olincollege/hoverbois/website/assets/images/jgilbert.jpg

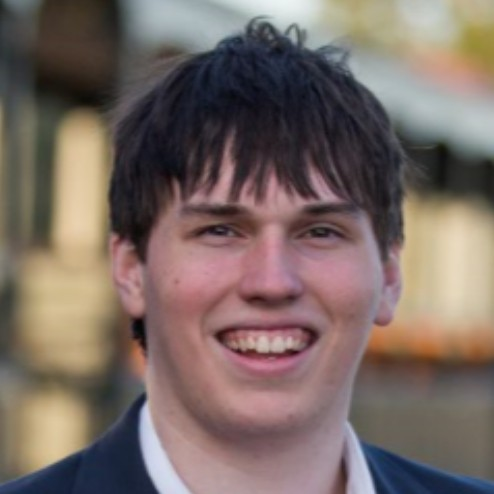
website/assets/images/jgilbert.jpg
