olincollege/hoverbois/README.md

# hoverbois
2022 pie project with William Skelly Devlin Ih Joseph Gilbert and Ethan Chen
