olincollege/hoverbois/website/content/docs/gallery/_index.md

---
title: Gallery
menu:
  navbar:
    weight: 20
---

# Media Gallery

# Videos:
{{<youtube 5YsUSeX58Ec>}}
{{< youtube F6ZGbz_ZIJE>}}
{{< youtube QIKaYoYOuRQ >}}

# Photos:

{{}}
{{}}
{{}}
{{}}
{{}}
{{}}
{{}}
{{}}
{{}}
