olincollege/hoverbois/website/assets/images/4View.jpg

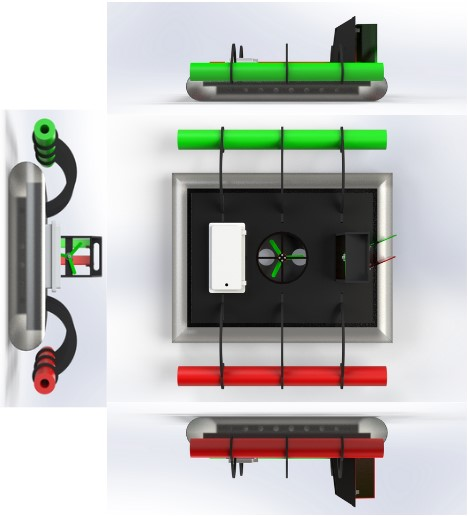
website/assets/images/4View.jpg
