olincollege/hoverbois/website/assets/images/Below_View.jpg

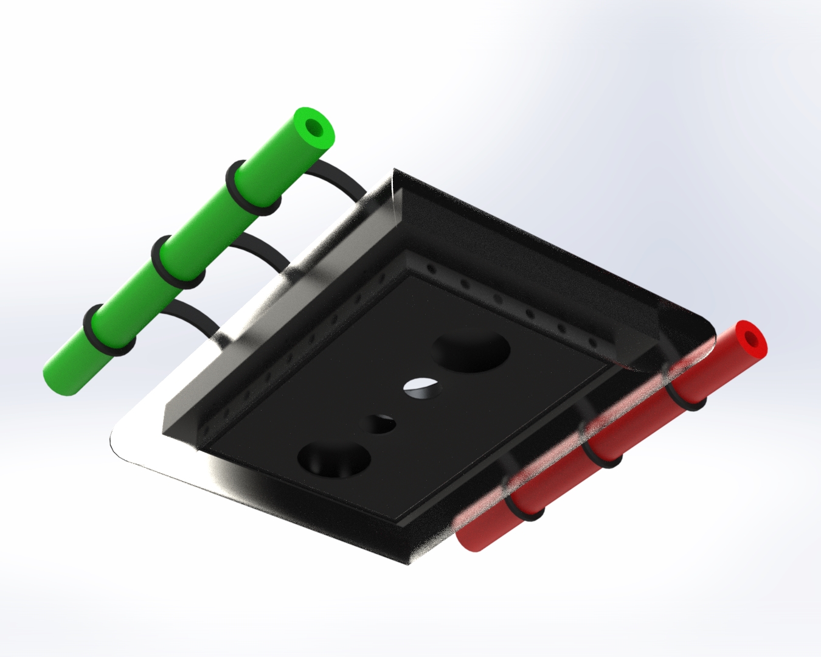
website/assets/images/Below_View.jpg
