olincollege/hoverbois/website/assets/images/devlin-ih.jpg

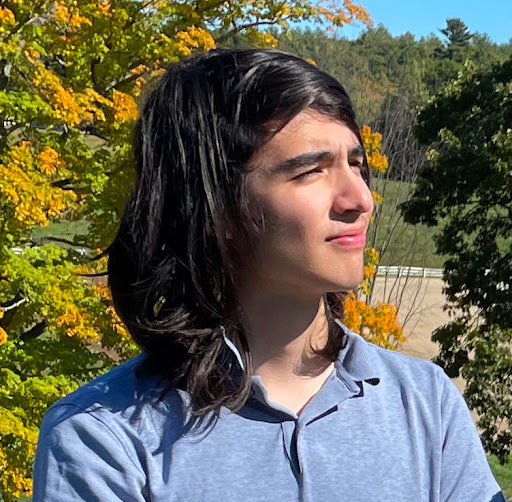
website/assets/images/devlin-ih.jpg
