olincollege/hoverbois/website/assets/images/Ethan_Chen.jpg

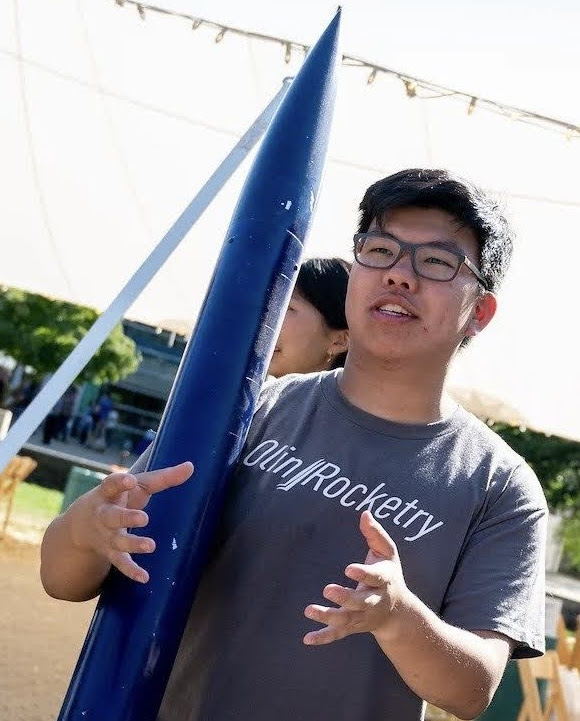
website/assets/images/Ethan_Chen.jpg
