olincollege/hoverbois/website/assets/images/Front_View.jpg

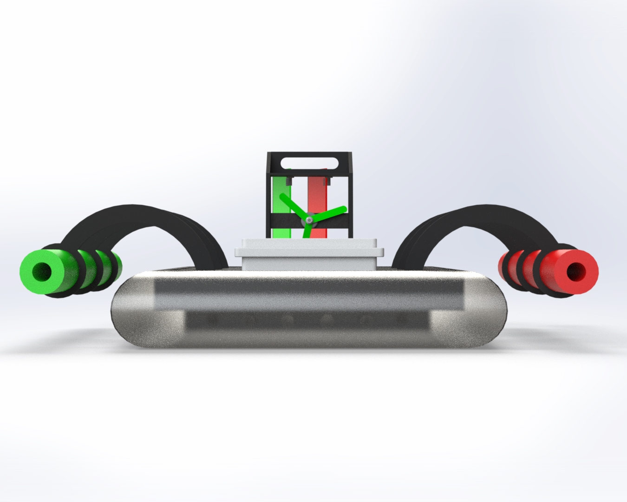
website/assets/images/Front_View.jpg
