olincollege/hoverbois/website/assets/images/IMG_1029.JPG

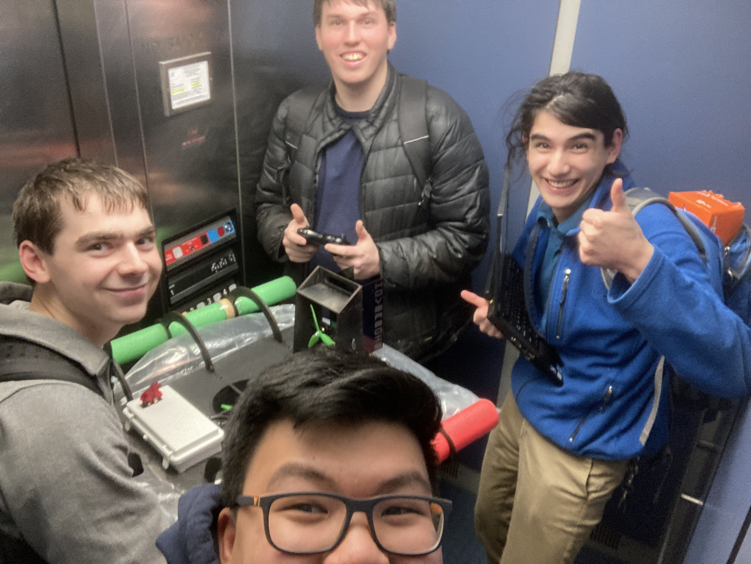
website/assets/images/IMG_1029.JPG
