olincollege/hoverbois/website/assets/images/IMG_1030.JPG

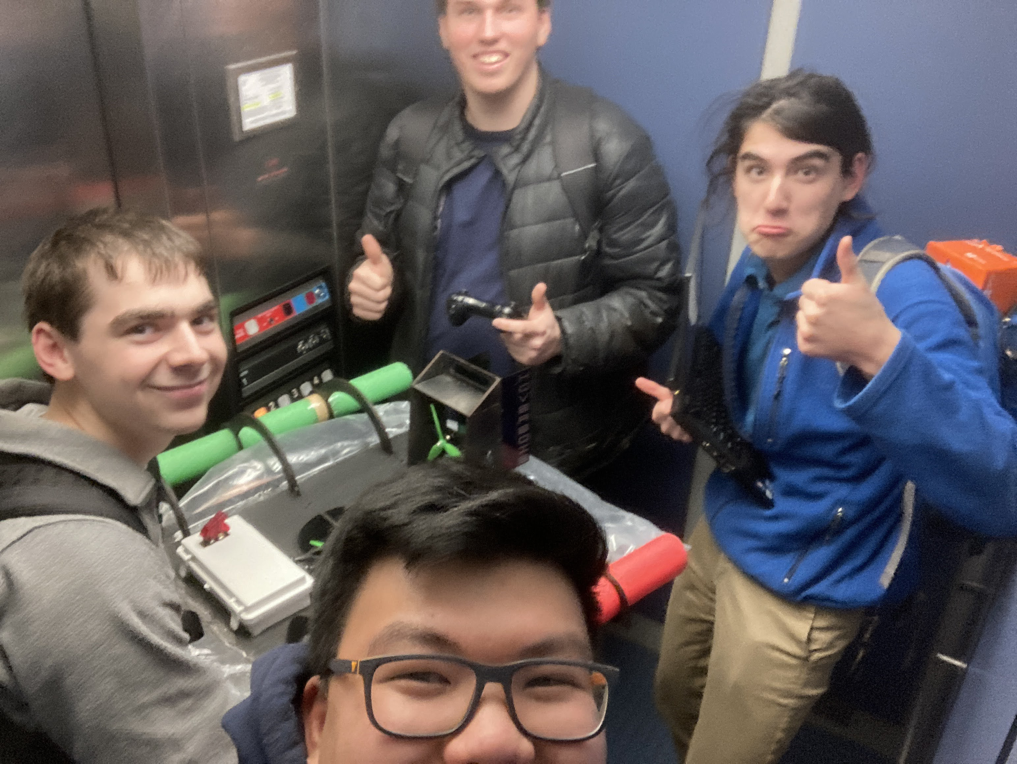
website/assets/images/IMG_1030.JPG
