olincollege/hoverbois/website/assets/images/IMG_1031.JPG

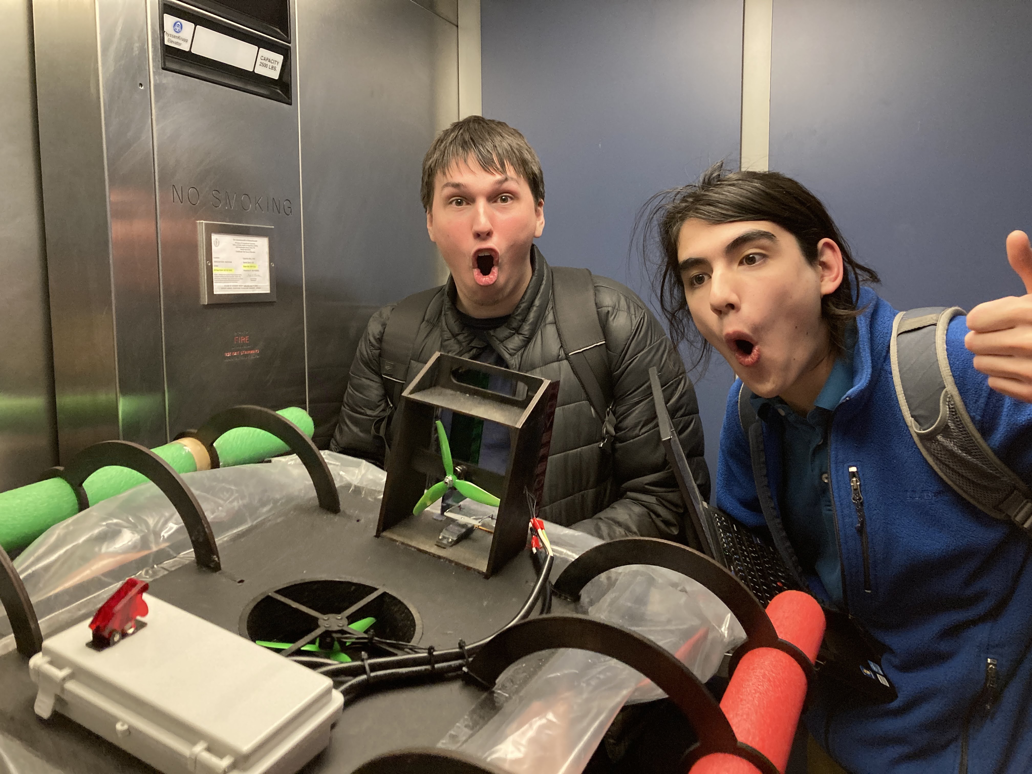
website/assets/images/IMG_1031.JPG
