olincollege/hoverbois/website/assets/images/IMG_1032.JPG

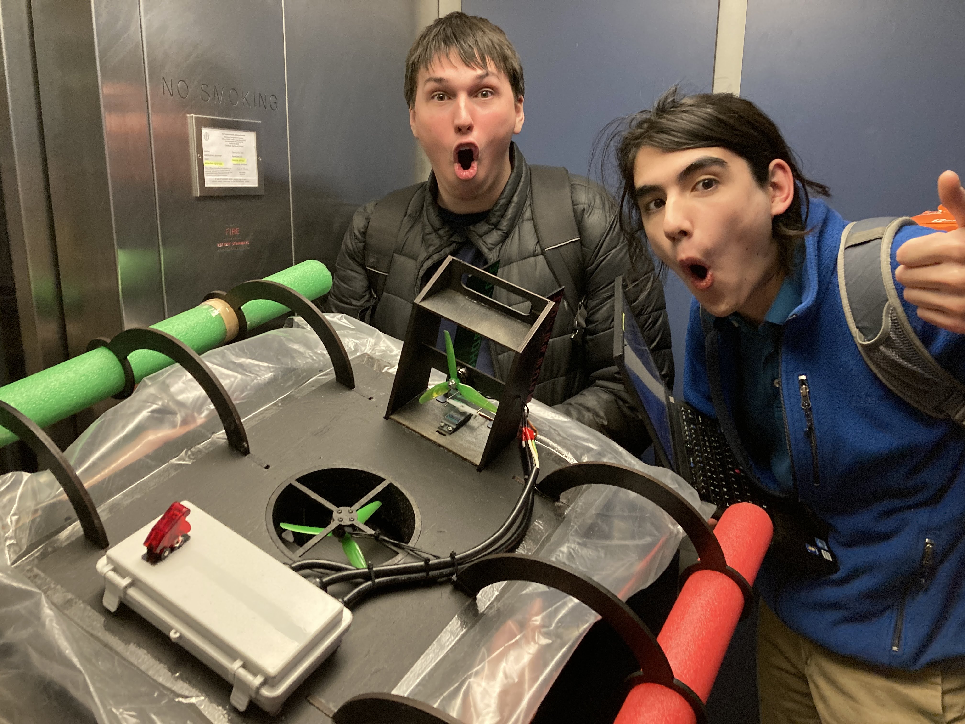
website/assets/images/IMG_1032.JPG
