olincollege/hoverbois/website/assets/images/Iso_Sharp.jpg

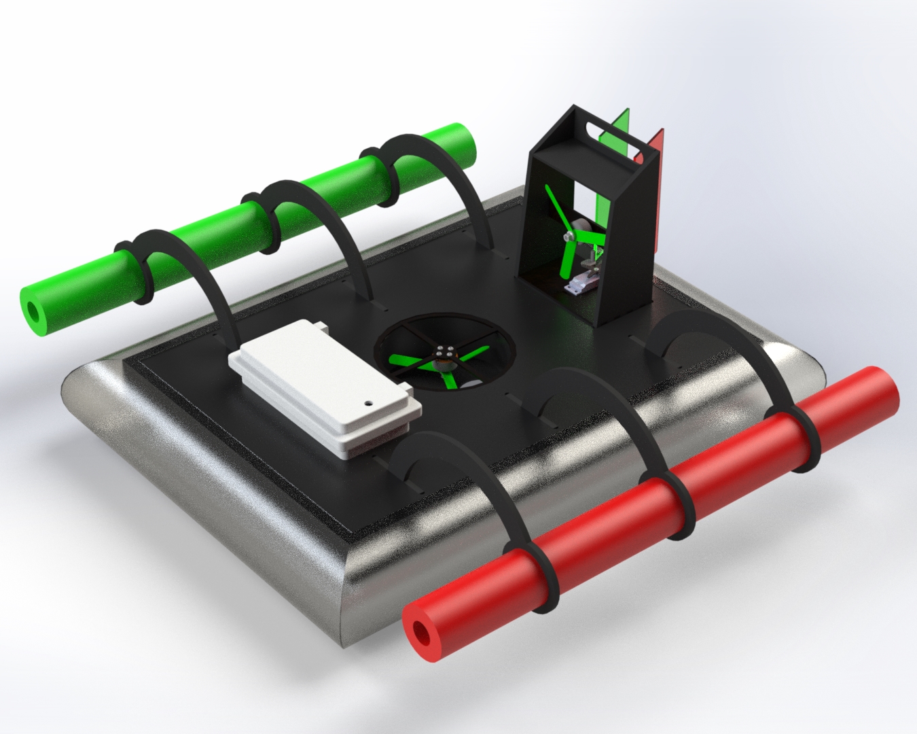
website/assets/images/Iso_Sharp.jpg
