olincollege/hoverbois/website/assets/images/Low_View.jpg

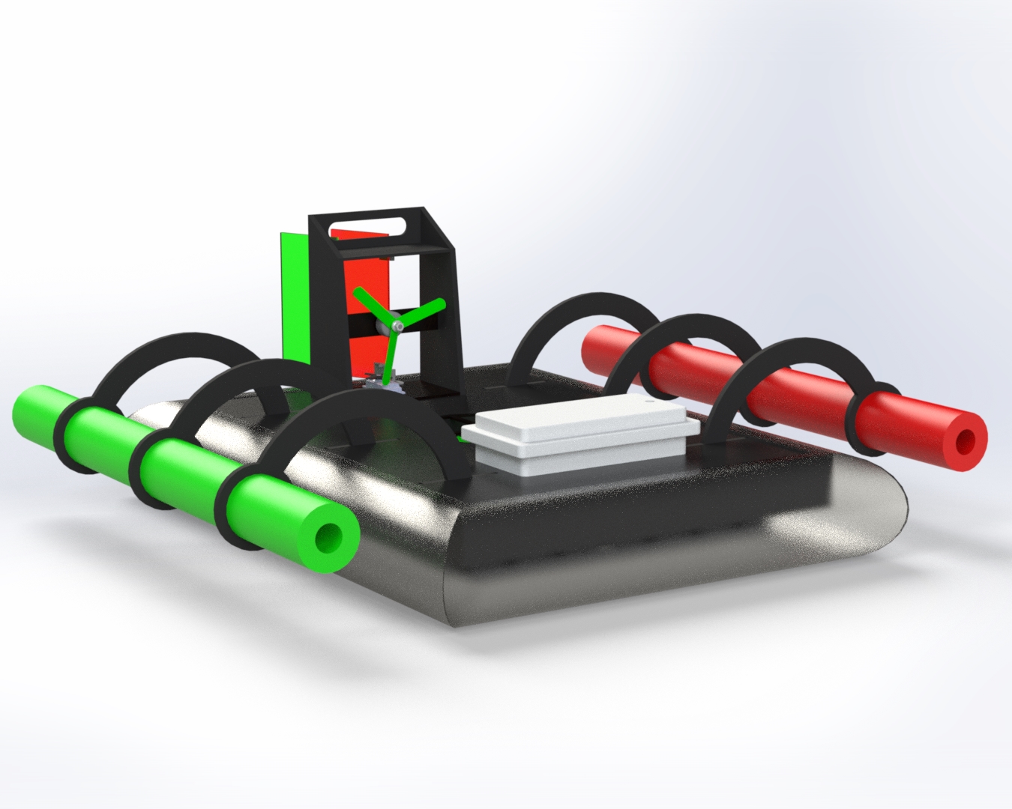
website/assets/images/Low_View.jpg
