olincollege/hoverbois/website/assets/images/Side_Port.jpg

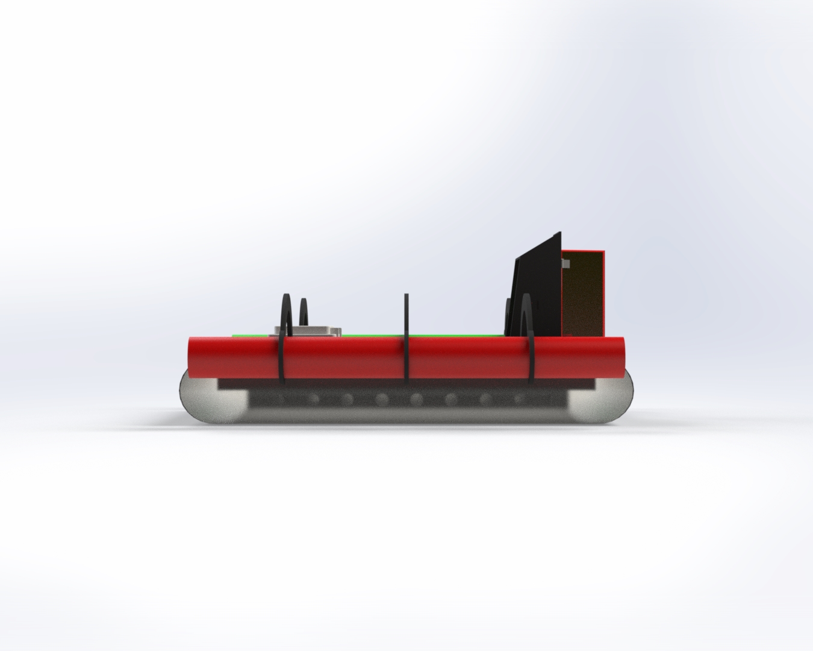
website/assets/images/Side_Port.jpg
