olincollege/hoverbois/website/assets/images/Side_Starboard.jpg

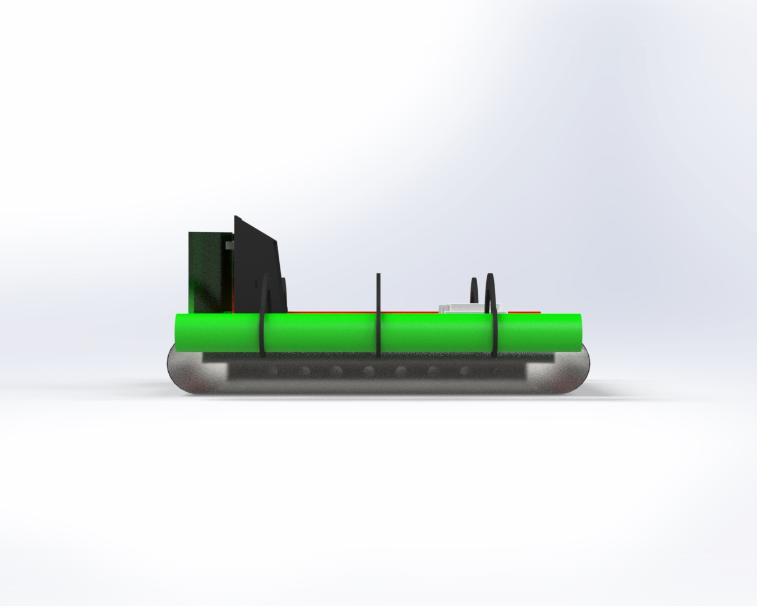
website/assets/images/Side_Starboard.jpg
