olincollege/hoverbois/website/assets/images/Skelly_Profile.jpg

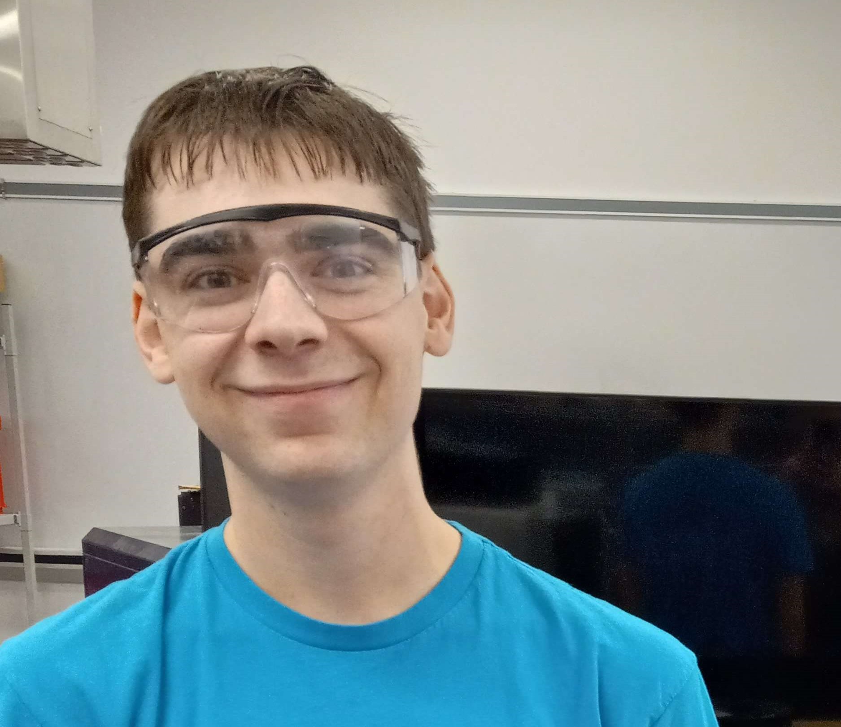
website/assets/images/Skelly_Profile.jpg
