olincollege/hoverbois/website/assets/images/Superstructure_Rear.jpg

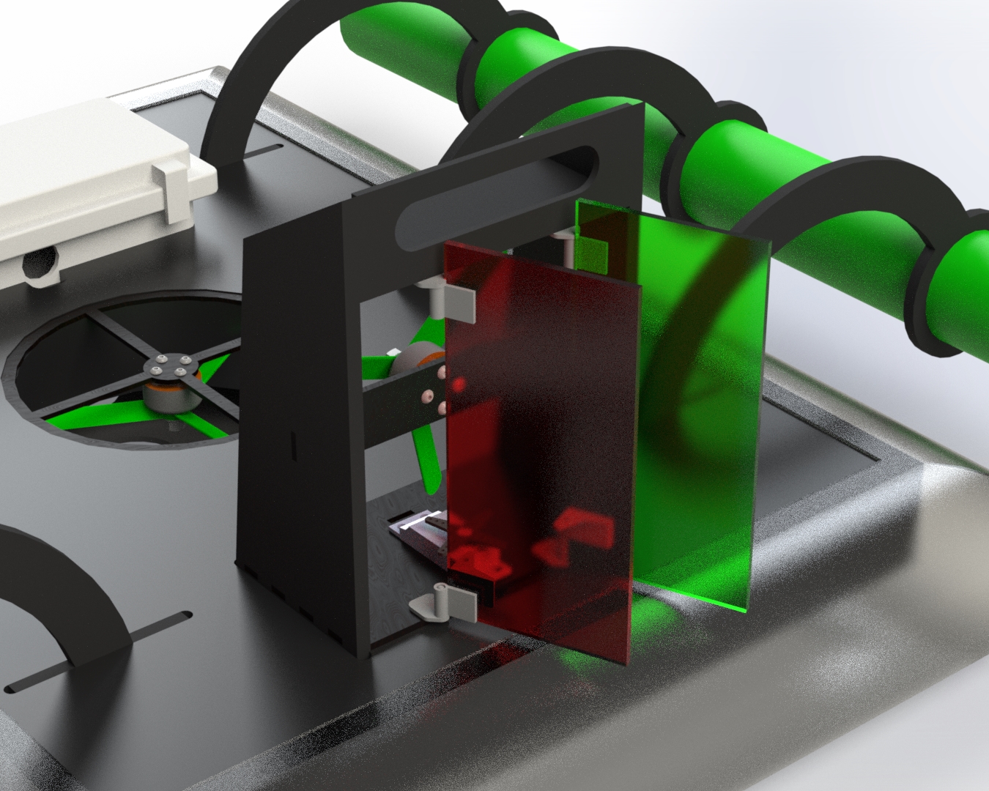
website/assets/images/Superstructure_Rear.jpg
