olincollege/hoverbois/website/assets/images/Supertructure.jpg

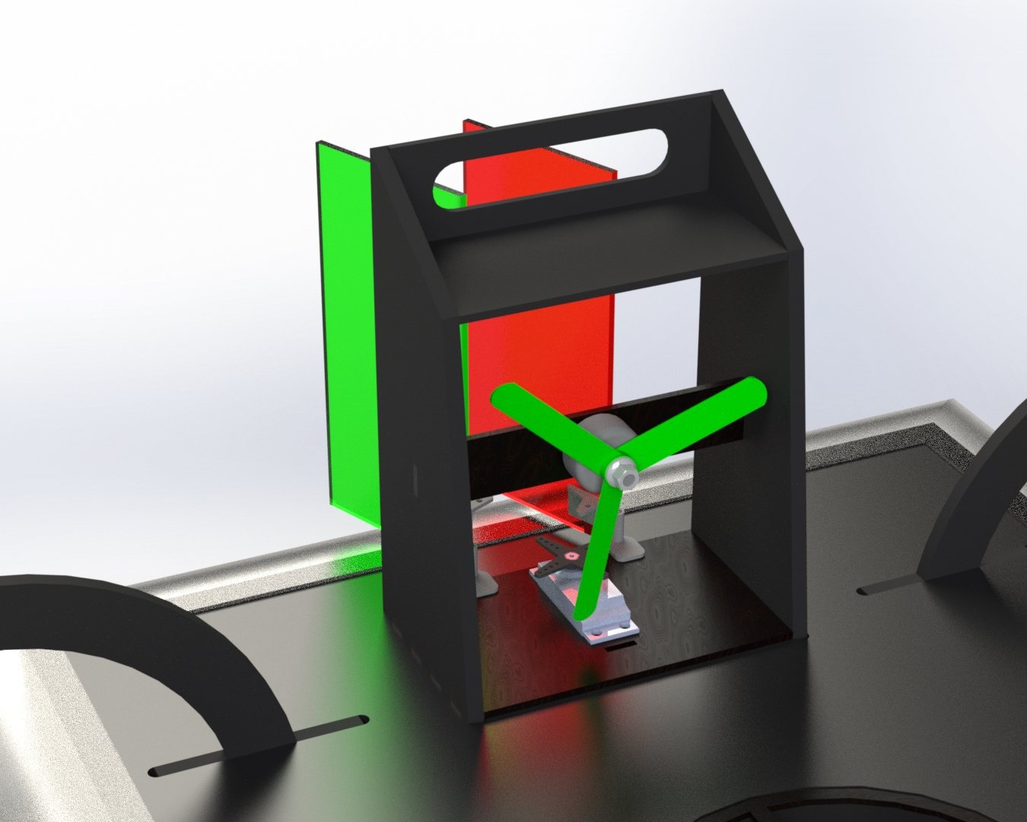
website/assets/images/Supertructure.jpg
