olincollege/hoverbois/website/assets/images/Top_View.jpg

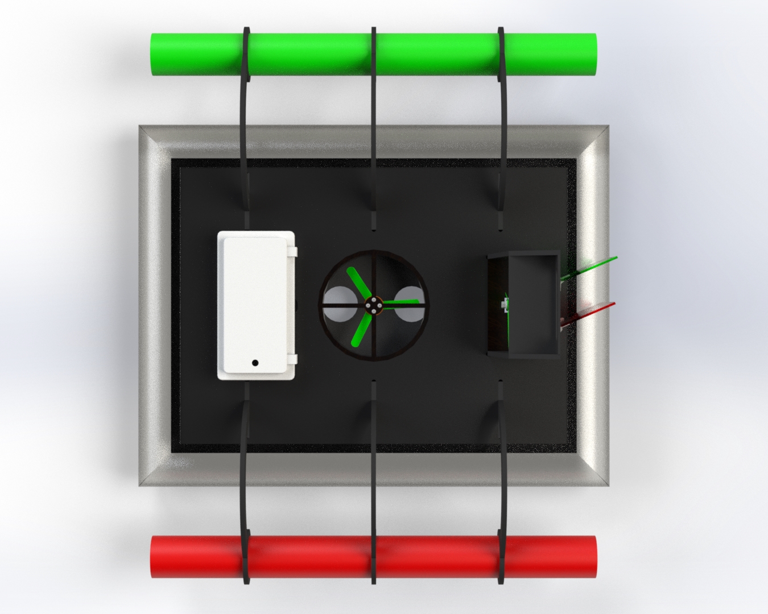
website/assets/images/Top_View.jpg
