olincollege/hoverbois/(commit log)

2022-10-21 firmware v1 rc 4 button works
2022-10-21 Add gitignore
    Github's Python template. Also works well enough for Arduino C++ projects too.
2022-10-23 Add debug command to print working directory
2022-10-23 Add debug command to print username
2022-10-24 added abc for driver and controller as well as sudo apt-get install rpi.gpio\ sudo apt-get install python3-rpi.gpio\ sudo pip3 install gpiozero\
    Reading package lists...
    Building dependency tree...
    Reading state information... script
2022-10-24 fixed minor pin bug
    [pi_pwm_simple.py]
2022-10-25 Implement dummy motor driver class
2022-10-25 web code worksbut still no driver interface
2022-10-25 acdded fan driver
2022-10-25 fixed missing pin def
2022-10-25 fixed more pin def things
    [pi_fan_simple.py]
2022-10-25 fixed minor bugs in fan driver code
    [pi_fan_simple.py]
2022-10-25 new pwm for fan testing
2022-10-25 changed code to use pico for fan
2022-10-30 Add new drivers and controller
2022-11-01 Make website printed on a new line
2022-11-04 Add skeleton code for PD control rudder correction
2022-11-05 added imu basic code and added datasheets for referances
2022-11-06 attemping to fix new pused code
    [imu_driver.py]
2022-11-06 attemping to fix new pushed code
    [imu_driver.py]
2022-11-07 IMU COMMS WORKS VERY POGGERS
2022-11-07 testing gyro range functions
2022-11-07 imu gyro cal works now
2022-11-08 Add magnet reading to defaults
2022-11-08 Hopefully fix a broken
    [imu_driver.py]
2022-11-08 Fix a broken for real
    [imu_driver.py]
2022-11-08 Fix another silly thing hopefully
    [imu_driver.py]
2022-11-08 Implement rotational correction driver
    [pi_pico_pid.py]
2022-11-08 Add dummy threaded driver for testing
2022-11-08 Refactor web_controller_simple a little bit
    Note: this isn't a pure refactor when it comes to running from command line.
    There is now a command line argument you must pass specifying driver type.
2022-11-08 Make threading_dummy behave more like the real PID
2022-11-08 Add new request handlers for calibrating PID manually
2022-11-08 Stop keeping track of the same thing twice
2022-11-08 added driver.forward and same for steering
2022-11-08 changed the prints in not forward to say not forwards
2022-11-08 fixed hover motor not working
    [PWM_Basic_test1.ino, pi_pico_simple.py]
2022-11-08 added devlins driver args code to webcontroller
2022-11-10 fixed typo in pi pico simple
    [pi_pico_simple.py]
2022-11-10 Fix issue where stop does not set hover to zero, rip IMU :(
    [pi_pico_simple.py]
2022-11-10 Fix servo limits
2022-11-10 fixed inverted steering
2022-11-10 fixed dict issue in pid
    [pi_pico_pid.py]
2022-11-10 testing new code on pid
2022-11-11 added gyro config
2022-11-11 fixed issue with imu driver and offset mag data
    [imu_driver.py, pi_pico_pid.py]
2022-11-11 testing new error correction
    [pi_pico_pid.py]
2022-11-11 add more error info
    [pi_pico_pid.py]
2022-11-14 added data logger to pico pid
2022-11-30 Calibrate axis
2022-11-30 Configure button map
2022-12-05 Merge bluetooth controller branch into main
    Implements a bluetooth controller for the hovercraft.
    Squashed commit of the following:
    commit b2422644147286e9167ba68f3589d1ad298a6208
    Author: Devlin Ih <dih@olin.edu>
    Date: Sun Dec 4 23:40:32 2022 -0500
    Add argparse to select driver type
    commit 95963471cea4c1d4aeecc6c3829981d27a896fe6
    Author: Devlin Ih <dih@olin.edu>
    Date: Sun Dec 4 23:34:13 2022 -0500
    Implement bluetooth controller
    commit 7ee8e428ac96585d8abba5517476334e8fb2d389
    Author: Devlin Ih <dih@olin.edu>
    Date: Sun Dec 4 21:52:18 2022 -0500
    Add evdev
2022-12-05 Fix issue where rudder angle was in wrong range
2022-12-06 Add readline for serial to make sure pico has finished
2022-12-06 fixed int sendong and servo config
    [pi_pico_simple.py]
2022-12-06 start of a very jank fix
    [pi_pico_simple.py]
2022-12-06 🤡 forgot a plus sign ➕
2022-12-06 😳 uncomment pyserial thing involving flush
2022-12-06 😔 Limit speed so Joseph doesn't crash and break the damn thing again
2022-12-06 😔typo fix😔
2022-12-11 More ME section work. Hover and Chassis section.
2022-12-13 Add buck converter to budget
2022-12-14 Lower limits further
    This is rather revealing about who should have their drivers license taken
    away.
2022-12-14 Increase throttle limit due to additional go pro weight
2022-12-15 Add electrical schematic image
2022-12-15 Adding CAD files
2022-12-15 Add CAD files download
2022-12-16 Remove TODOs and fix issue incorrect statement about motor control
    pwm not dshot
