olincollege/hoverbois/website/assets/images/IMG_20221205_210039_939.jpg

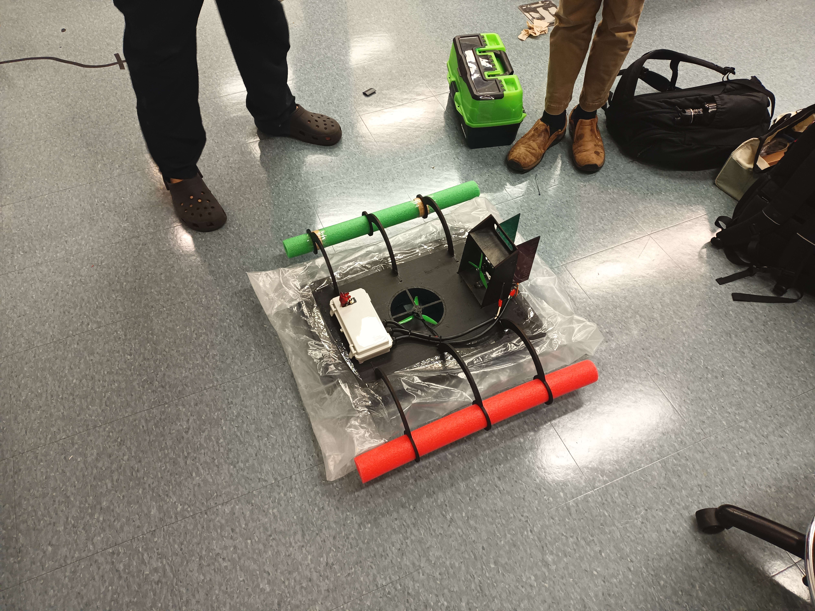
website/assets/images/IMG_20221205_210039_939.jpg
