olincollege/hoverbois/website/assets/images/IMG_20221205_210051_526.jpg

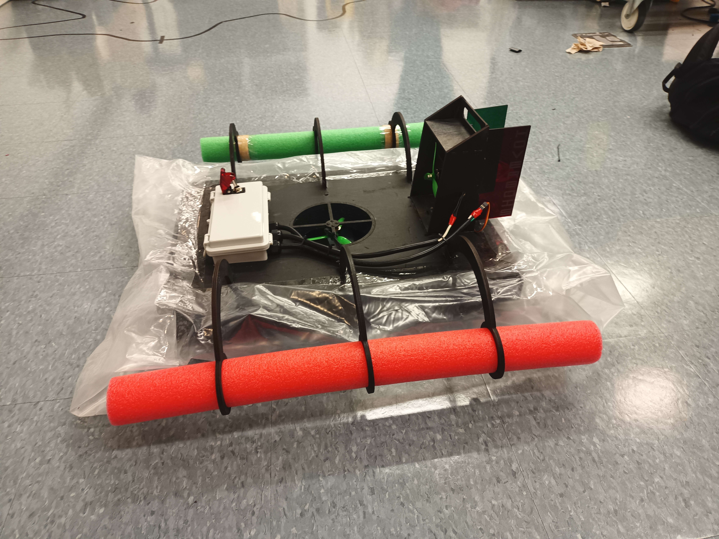
website/assets/images/IMG_20221205_210051_526.jpg
