olincollege/hoverbois/website/assets/images/IMG_20221205_210104_679.jpg

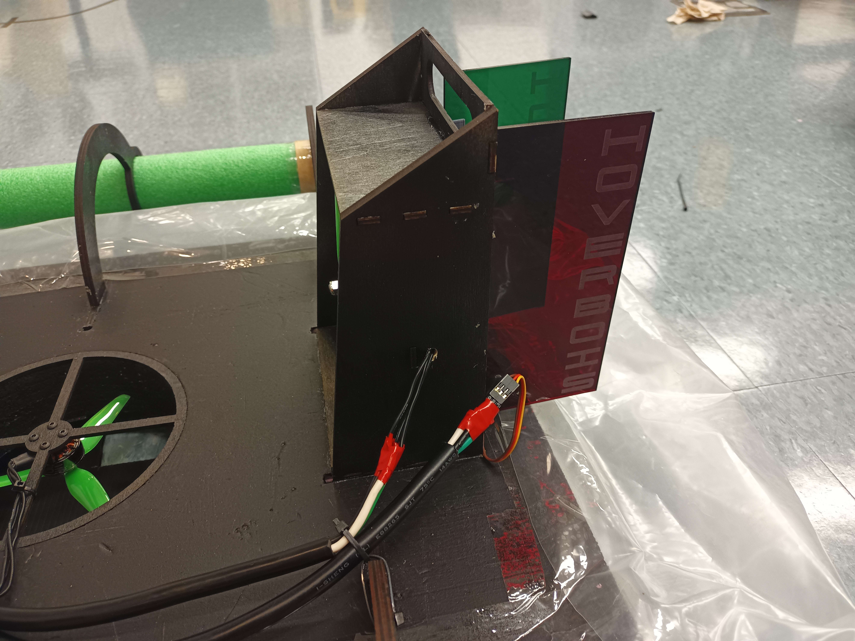
website/assets/images/IMG_20221205_210104_679.jpg
