olincollege/hoverbois/website/assets/images/electronics_box.jpg

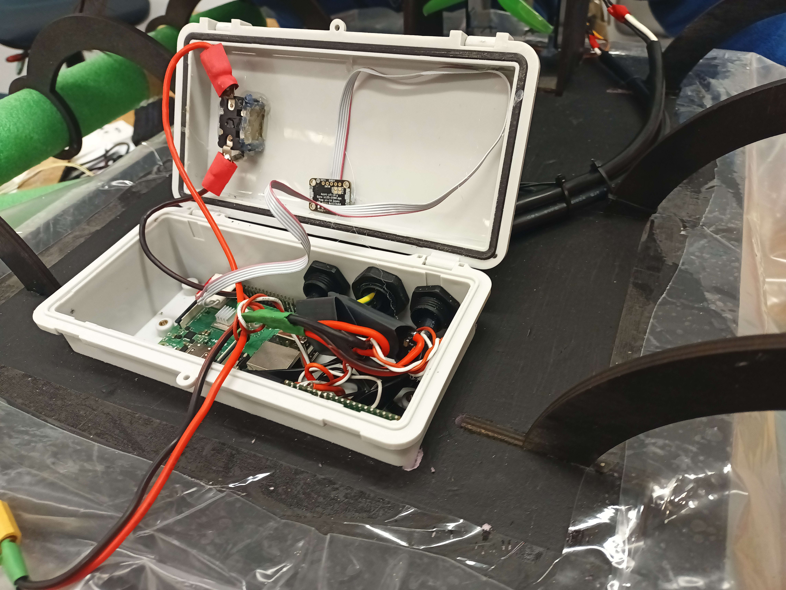
website/assets/images/electronics_box.jpg
